open-ephys/eib-64-nanoz-adapter/README.md

## EIB-64 NanoZ Adapter

Adapter to interface [Open Ephys 64ch EIB](https://github.com/open-ephys/eib-64) with the popular nanoZ electrode impedance tester and plating device.
