open-ephys/eib-64-nanoz-adapter/PCB/production/eib-64-nanoz-adapter BOM.xlsx

Qty | OEPS PN | Schematic Name | MPN
1 | OEPS070068 | J1 | DF40C-70DP-0.4V(51)
2 | OEPS070132 | J2, J3 | MOLC-110-11-S-Q
1 | OEPS070133 | J4 | OSTVN02A150
