open-ephys/eib-64-nanoz-adapter/PCB/eib-64-nanoz-adapter.pdf

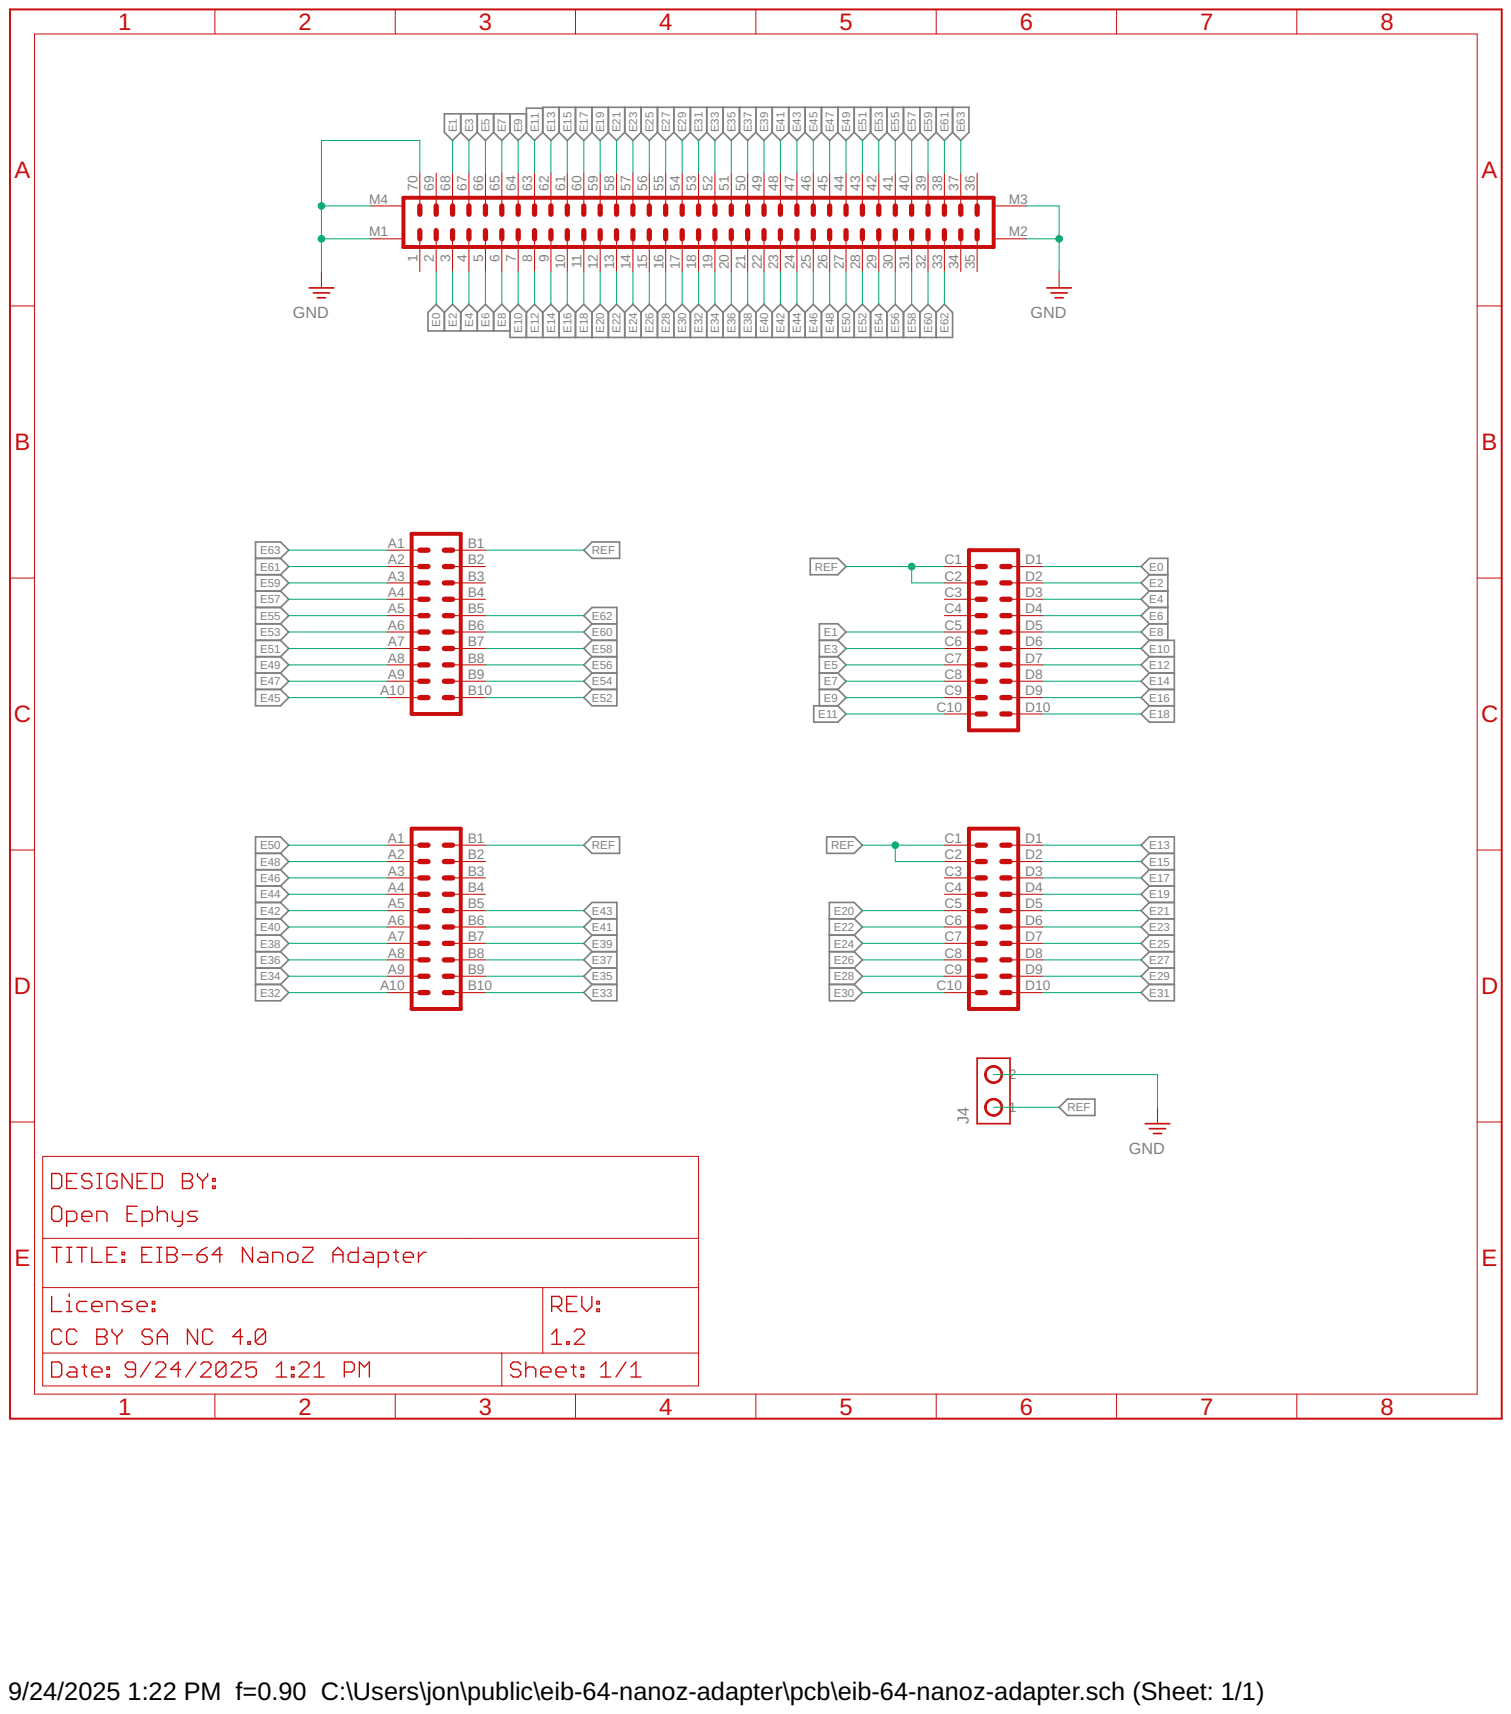
[picture p1: page 1]

9/24/2025 1:22 PM f=0.90 C:\Users\jon\public\eib-64-nanoz-adapter\pcb\eib-64-nanoz-adapter.sch (Sheet: 1/1)
