open-ephys/eib-64-nanoz-adapter/(threads)

Thread 2 (2025-03-12):

Connector spacing issue?

ChucklesOnGitHub, 2025-03-12:
There seems to be a issue in the spacing between connectors at either at a design or manufacturing level.

We've had a user report they cannot plug our adapter-64 (rev1.0) into the NanoZ (v1.3). They have been using a different adapter for an omnetics-based EIB (ADPT-NX-EIB-32/36 rev 1) which fits the NanoZ just fine and have shared images of the misalignment between both adapters (since the misalignment between the NanoZ and our adapter is hard to capture on picture).

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

Seemingly, the same issue was reported [here](https://groups.google.com/g/open-ephys/c/xTc9H_jmoxg/m/TqXqHpV1AgAJ), pointing to a design issue. The picture shows rev 1.1 on the silkscreen of the adapter (manufactured by the user).

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

I'm not sure what the resolution was. In that same thread, other users reported that a fully assembled one from the store worked well and it's the first time I hear this, so would the recent report be a manufacturing issue? What QA do we have for this?

ChucklesOnGitHub, 2025-03-17:
Manufacturer says "We haven’t changed the nanoZ’s Samtec connector spacing since it was first released in 2010.  They are spaced exactly 17.0mm apart, center to center."

Closed 2025-09-25.
