open-ephys/eib-64-nanoz-adapter/(commit log)

2025-09-24 Added PCB and schematic
    Fix #2
    [eib-64-nanoz-adapter.brd, eib-64-nanoz-adapter.sch]
2025-09-24 Added .gitignore for Eagle CAD
2025-09-24 Added BOM
    [eib-64-nanoz-adapter BOM.xlsx]
2025-09-24 Added production files
    [copper_bottom_l4.gbr, copper_inner_l2.gbr, copper_inner_l3.gbr, copper_top_l1.gbr, drill_1_16.xln, gerber_job.gbrjob, profile.gbr, silkscreen_bottom.gbr]
2025-09-24 Change licence to CC BY SA NC 4.0
    [eib-64-nanoz-adapter.brd, eib-64-nanoz-adapter.sch]
