open-ephys/eib-64-nanoz-adapter/(notices)

Notices in the files:
PCB/eib-64-nanoz-adapter.sch:
LICENSE: CC BY SA NC 4.0
